FoRTE-Research/EnergyReplay/energyReplay/energyReplay.pdf

energyReplay

# Reference | Qty Value

1 C1, C2, C3, C4 | 4 100n
2 C5 | 1 10u
3 C6 | 1 2.2n
4 C7 | 1 0.1u
5 C8 | 1 4.7u
6 C9, C10 | 2 11u
7 H1, H2, H3, H4 | 4 MountingHole
8 J1 | 1 Conn_02x07_Odd_Even
9 J2 | 1 Power Select
10 J3, J4, J6, J7 | 4 Conn_01x02_Pin
11 J5 | 1 Conn_02x10_Counter_Clockwise
12 L1 | 1 2.2u
13 LED1 | 1 LTST-C155GEKT
14 LED2 | 1 19-237/R6GHBHC-A04/2T
15 R1 | 1 47k
16 R2 | 1 150
17 R3 | 1 120
18 R4 | 1 110
19 R5 | 1 20
20 R6 | 1 43
21 R7, R8 | 2 4.7k
22 R9 | 1 10k
23 R10 | 1 12k
24 R11 | 1 120k
25 R12 | 1 68k
26 R13 | 1 500m
27 R14, R15 | 2 1k
28 R16, R17 | 2 150k
29 SW1, SW2 | 2 SW_Push
30 U1 | 1 MSP430FR5994IPN
31 U2 | 1 MCP4725xxx-xCH
32 U3 | 1 OPA2387DGKR
33 U4 | 1 TPS613222ADBV
34 U5 | 1 LM66100DCKR

energyReplay

Footprint | DNP
Capacitor_SMD:C_1206_3216Metric Capacitor_SMD:C_1206_3216Metric Capacitor_SMD:C_1206_3216Metric Capacitor_SMD:C_1206_3216Metric Capacitor_SMD:C_1206_3216Metric Capacitor_SMD:C_1206_3216Metric MountingHole:MountingHole_3.2mm_M3 Connector_PinHeader_2.54mm:PinHeader_2x07_P2.54mm_Vertical Connector_PinHeader_2.54mm:PinHeader_1x03_P2.54mm_Vertical Connector_PinHeader_2.54mm:PinHeader_1x02_P2.54mm_Vertical Connector_PinHeader_2.54mm:PinHeader_2x10_P2.54mm_Vertical Inductor_SMD:L_1206_3216Metric LTST-C155GEKT:DIODE_LTST-C155GEKT_LTO EAST1616RGBA3:EAST1616RGB_SMD_B_EVE Resistor_SMD:R_1206_3216Metric Resistor_SMD:R_1206_3216Metric Resistor_SMD:R_1206_3216Metric Resistor_SMD:R_1206_3216Metric Resistor_SMD:R_1206_3216Metric Resistor_SMD:R_1206_3216Metric Resistor_SMD:R_1206_3216Metric Resistor_SMD:R_1206_3216Metric Resistor_SMD:R_1206_3216Metric Resistor_SMD:R_1206_3216Metric Resistor_SMD:R_1206_3216Metric Resistor_SMD:R_1206_3216Metric Resistor_SMD:R_1206_3216Metric Resistor_SMD:R_1206_3216Metric TL59NF160Q:SW_TL59NF160Q
MSP430FR5994IPN:PN0080A_N
Package_TO_SOT_SMD:SOT-23-6 OPA2387DGK:DGK0008A-IPC_A
Package_TO_SOT_SMD:SOT-23-5 LM66100DCKR:DCK6_TEX
