FoRTE-Research/EnergyReplay/energyReplay/energyReplay.csv

Id | Designator | Footprint | Quantity | Designation | Supplier and ref
1 | R13 | R_1206_3216Metric | 1 | 500m
2 | R12 | R_1206_3216Metric | 1 | 68k
3 | SW2,SW1 | SW_TL59NF160Q | 2 | SW_Push
4 | LED1 | DIODE_LTST-C155GEKT_LTO | 1 | LTST-C155GEKT
5 | J7,J3,J6,J4 | PinHeader_1x02_P2.54mm_Vertical | 4 | Conn_01x02_Pin
6 | C12,C3,C4,C1,C2,C11 | C_1206_3216Metric | 6 | 100n
7 | H1,H2,H4,H3 | MountingHole_3.2mm_M3 | 4 | MountingHole
8 | C9,C10 | C_1206_3216Metric | 2 | 22u
9 | R10 | R_1206_3216Metric | 1 | 12k
10 | C8 | C_1206_3216Metric | 1 | 4.7u
11 | U4 | SOT-23-5 | 1 | TPS613222ADBV
12 | C6 | C_1206_3216Metric | 1 | 2.2n
13 | J5 | PinHeader_2x10_P2.54mm_Vertical | 1 | Conn_02x10_Counter_Clockwise
14 | R1 | R_1206_3216Metric | 1 | 47k
15 | LED2 | EAST1616RGB_SMD_B_EVE | 1 | 19-237/R6GHBHC-A04/2T
16 | R7,R8 | R_1206_3216Metric | 2 | 4.7k
17 | R11 | R_1206_3216Metric | 1 | 120k
18 | R4 | R_1206_3216Metric | 1 | 110
19 | U3 | DGK0008A-IPC_A | 1 | OPA2387DGKR
20 | R9 | R_1206_3216Metric | 1 | 10k
21 | R6 | R_1206_3216Metric | 1 | 43
22 | U5 | DCK6_TEX | 1 | LM66100DCKR
23 | R14,R15 | R_1206_3216Metric | 2 | 1k
24 | U2 | SOT-23-6 | 1 | MCP4725xxx-xCH
25 | U1 | PN0080A_N | 1 | MSP430FR5994IPN
26 | C5 | C_1206_3216Metric | 1 | 10u
27 | J1 | PinHeader_2x07_P2.54mm_Vertical | 1 | Conn_02x07_Odd_Even
28 | J2 | PinHeader_1x03_P2.54mm_Vertical | 1 | Power Select
29 | R3 | R_1206_3216Metric | 1 | 120
30 | C7 | C_1206_3216Metric | 1 | 0.1u
31 | Y1 | XTAL_MS1V-T1K-32.768KHZ-12.5PF-20PPM-TA-QC | 1 | Crystal
32 | L1 | L_1210_3225Metric | 1 | 2.2u
33 | R16,R17 | R_1206_3216Metric | 2 | 150k
34 | R2 | R_1206_3216Metric | 1 | 150
35 | R5 | R_1206_3216Metric | 1 | 20
