FoRTE-Research/EnergyReplay/pdf/pcb.pdf

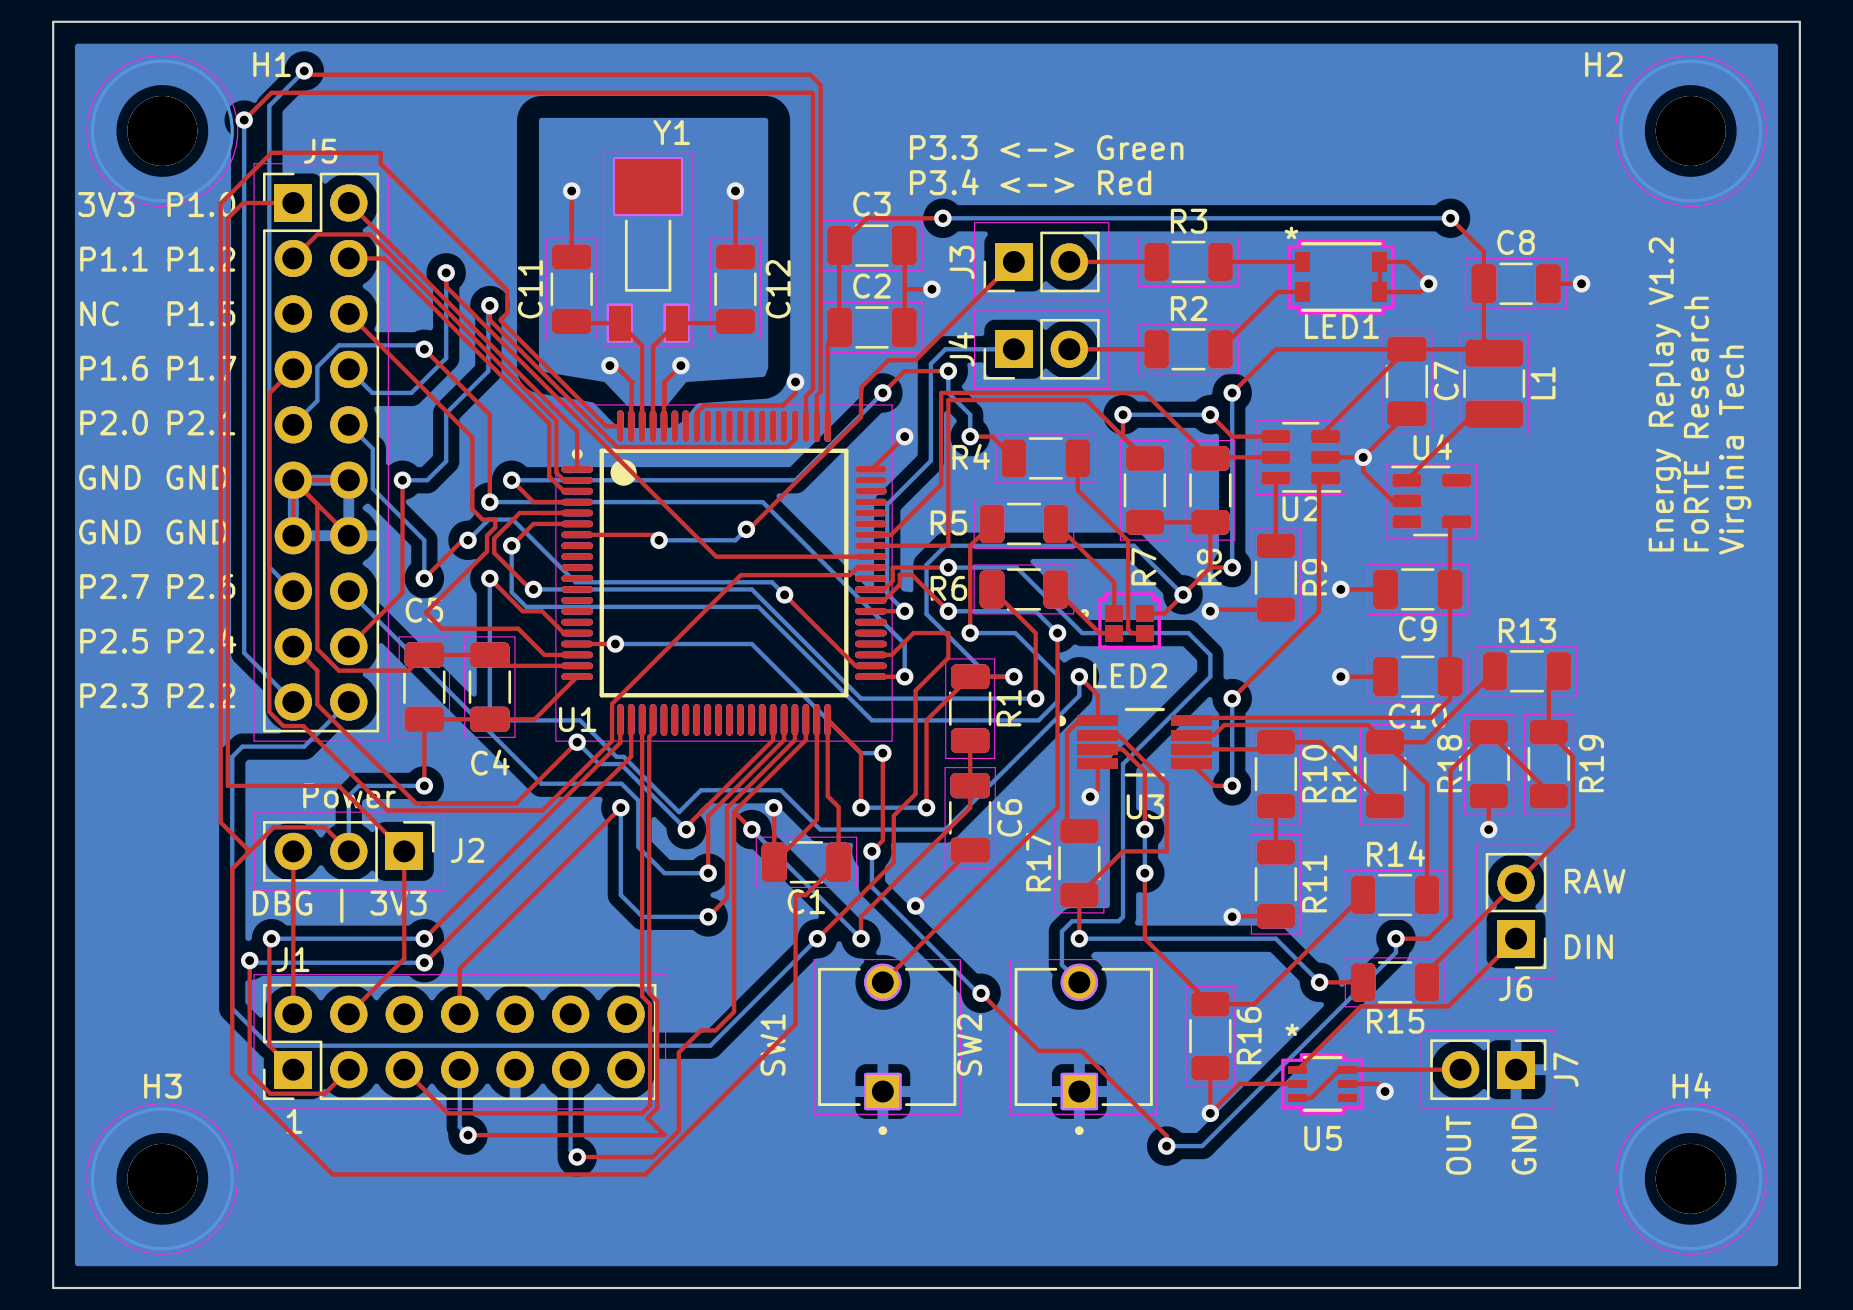
[picture p1: page 1]
