FoRTE-Research/EnergyReplay/spice/diffAmp.asc

I1: current; SINE(20m 20m 1)
R1: res; 1Meg
R2: res; 500m
R3: res; 1k
R4: res; 1k
R5: res; 150k
R6: res; 150k
R7: res; 1k
U1: UniversalOpAmp
V1: voltage; 5
Named nets: 0, Vdd, Vout, Vhi, Vlo
.tran 20
