FoRTE-Research/EnergyReplay/spice/gainAmp.asc

R1: res; 100Meg
R2: res; 68k
R3: res; 120k
R4: res; 12k
U1: UniversalOpAmp
V1: voltage; 5
V2: voltage; SINE(0 3.3 1)
Named nets: 0, Vdd
