FoRTE-Research/EnergyReplay/energyReplay/energyReplay.kicad_pcb

## KiCad design energyReplay/energyReplay.kicad_pcb (2025-04-21)

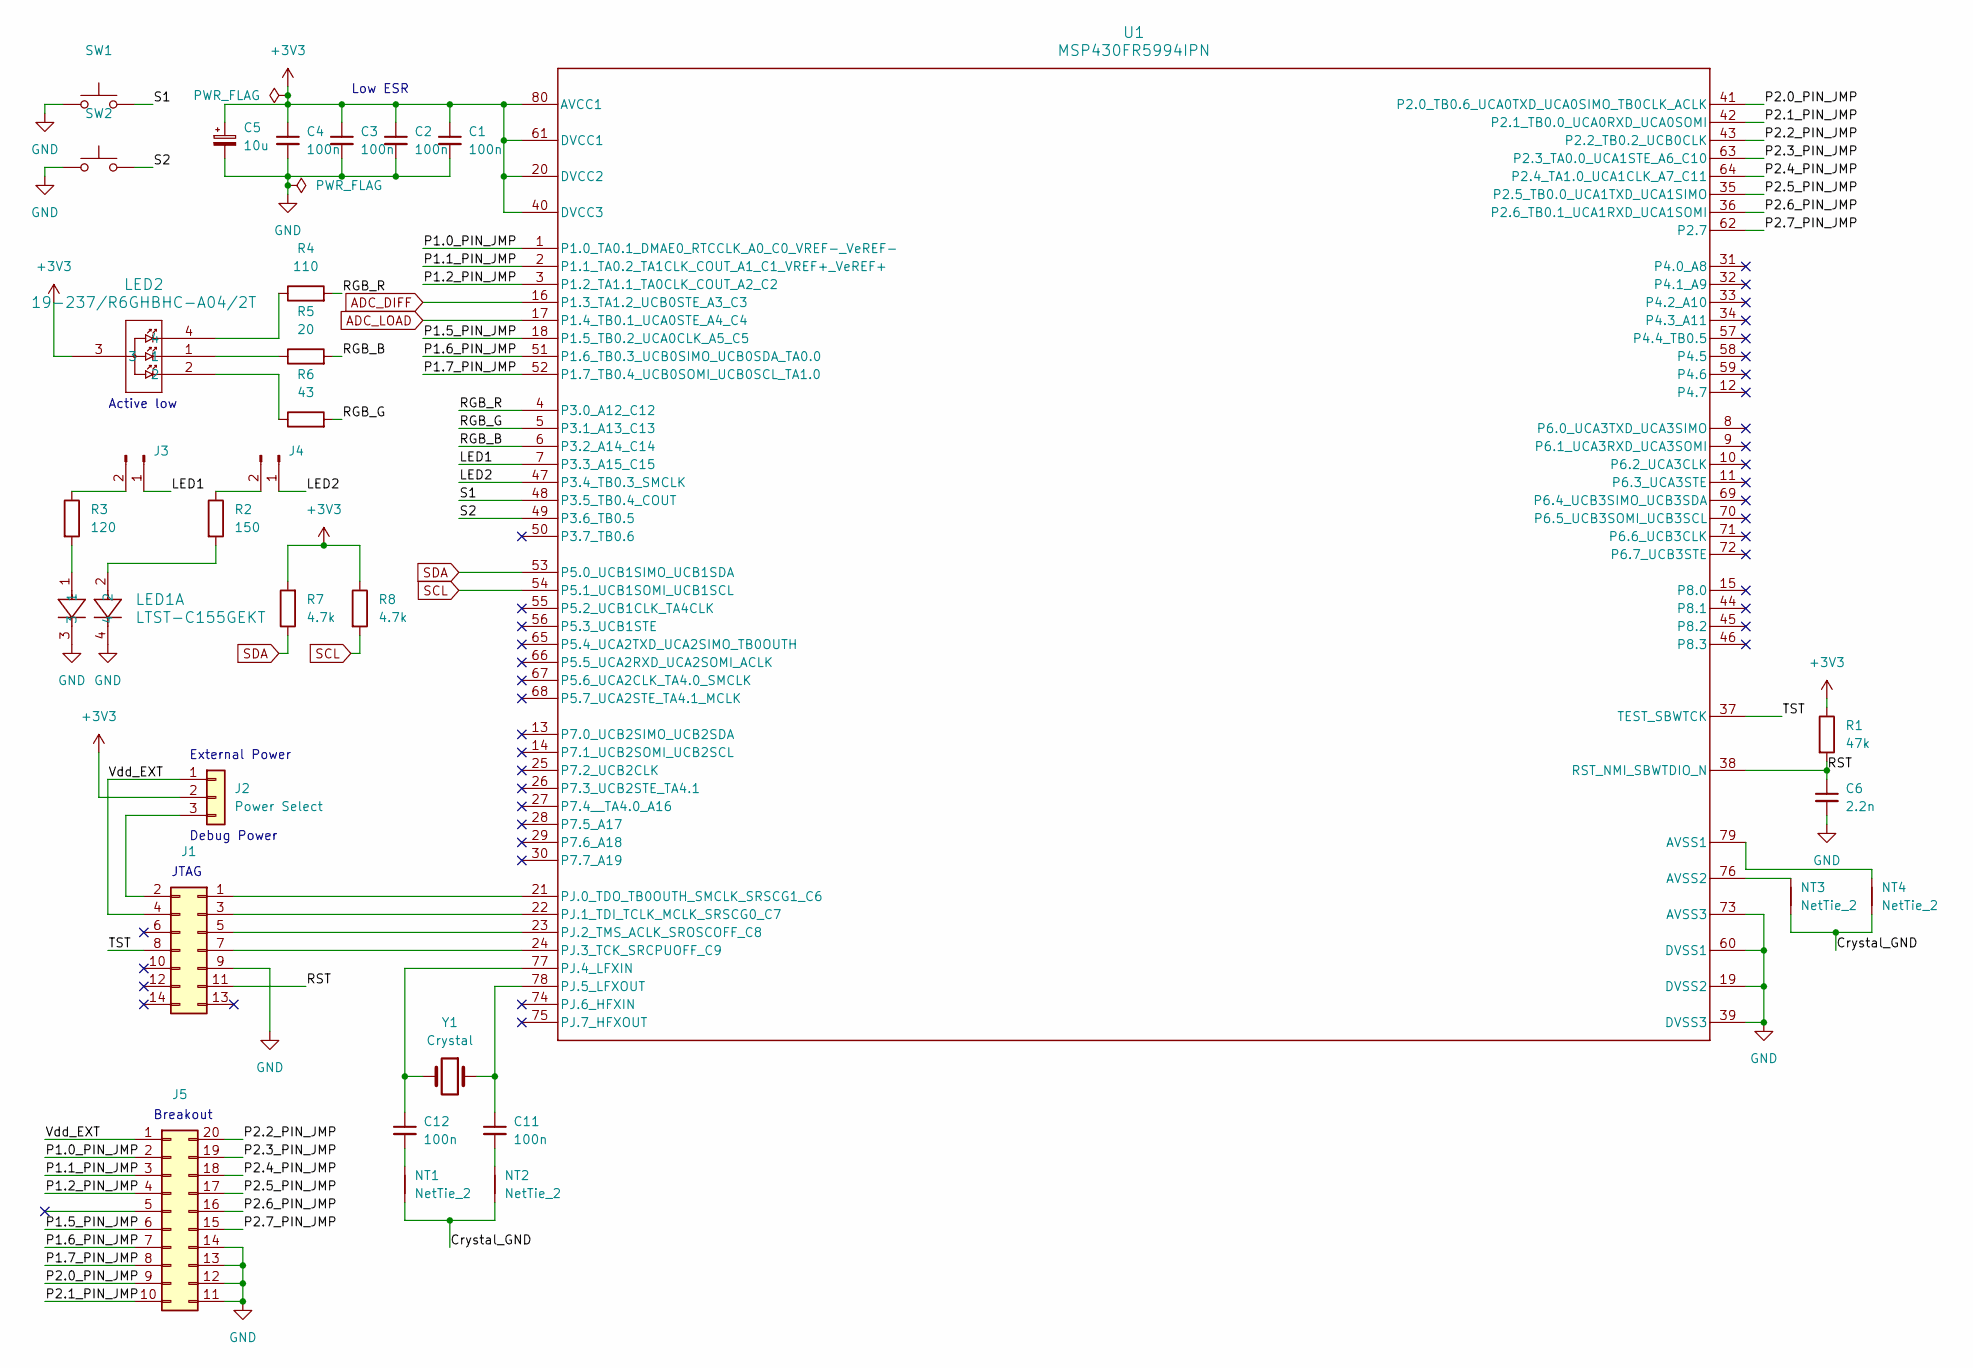
[picture p5: schematic Control.kicad_sch, Control MCU]

Parts:
C1, C2, C3, C4, C11, C12: 100n; C_1206_3216Metric
C5: 10u; C_1206_3216Metric
C6: 2.2n; C_1206_3216Metric
J1: Conn_02x07_Odd_Even; PinHeader_2x07_P2.54mm_Vertical
J2: Power Select; PinHeader_1x03_P2.54mm_Vertical
J3, J4: Conn_01x02_Pin; PinHeader_1x02_P2.54mm_Vertical
J5: Conn_02x10_Counter_Clockwise; PinHeader_2x10_P2.54mm_Vertical
LED1: LTST-C155GEKT; DIODE_LTST-C155GEKT_LTO
LED2: 19-237/R6GHBHC-A04/2T; EAST1616RGB_SMD_B_EVE
NT1, NT2, NT3, NT4: NetTie_2; NetTie-2_SMD_Pad0.2mm
R1: 47k; R_1206_3216Metric
R2: 150; R_1206_3216Metric
R3: 120; R_1206_3216Metric
R4: 110; R_1206_3216Metric
R5: 20; R_1206_3216Metric
R6: 43; R_1206_3216Metric
R7, R8: 4.7k; R_1206_3216Metric
SW1, SW2: SW_Push; SW_TL59NF160Q
U1: MSP430FR5994IPN; PN0080A_N
Y1: Crystal; XTAL_MS1V-T1K-32.768KHZ-12.5PF-20PPM-TA-QC

Connections:
+3V3: C1.1, C2.1, C3.1, C4.1, C5.1, J2.2, LED2.3, R1.1, R7.2, R8.1, U1.20 (DVCC2), U1.40 (DVCC3), U1.61 (DVCC1), U1.80 (AVCC1); also elsewhere on the board
/Control/Crystal_GND: NT1.1, NT2.1, NT3.1, NT4.1
/Control/LED1: J3.1, U1.7 (P3.3_A15_C15)
/Control/LED2: J4.1, U1.47 (P3.4_TB0.3_SMCLK)
/Control/P1.0_PIN_JMP: J5.2, U1.1 (P1.0_TA0.1_DMAE0_RTCCLK_A0_C0_VREF-_VeR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)
/Control/P1.1_PIN_JMP: J5.3, U1.2 (P1.1_TA0.2_TA1CLK_COUT_A1_C1_VREF+_VeRE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)
/Control/P1.2_PIN_JMP: J5.4, U1.3 (P1.2_TA1.1_TA0CLK_COUT_A2_C2)
/Control/P1.5_PIN_JMP: J5.6, U1.18 (P1.5_TB0.2_UCA0CLK_A5_C5)
/Control/P1.6_PIN_JMP: J5.7, U1.51 (P1.6_TB0.3_UCB0SIMO_UCB0SDA_TA0.0)
/Control/P1.7_PIN_JMP: J5.8, U1.52 (P1.7_TB0.4_UCB0SOMI_UCB0SCL_TA1.0)
/Control/P2.0_PIN_JMP: J5.9, U1.41 (P2.0_TB0.6_UCA0TXD_UCA0SIMO_TB0CLK_ACLK)
/Control/P2.1_PIN_JMP: J5.10, U1.42 (P2.1_TB0.0_UCA0RXD_UCA0SOMI)
/Control/P2.2_PIN_JMP: J5.20, U1.43 (P2.2_TB0.2_UCB0CLK)
/Control/P2.3_PIN_JMP: J5.19, U1.63 (P2.3_TA0.0_UCA1STE_A6_C10)
/Control/P2.4_PIN_JMP: J5.18, U1.64 (P2.4_TA1.0_UCA1CLK_A7_C11)
/Control/P2.5_PIN_JMP: J5.17, U1.35 (P2.5_TB0.0_UCA1TXD_UCA1SIMO)
/Control/P2.6_PIN_JMP: J5.16, U1.36 (P2.6_TB0.1_UCA1RXD_UCA1SOMI)
/Control/P2.7_PIN_JMP: J5.15, U1.62 (P2.7)
/Control/RGB_B: R5.2, U1.6 (P3.2_A14_C14)
/Control/RGB_G: R6.2, U1.5 (P3.1_A13_C13)
/Control/RGB_R: R4.2, U1.4 (P3.0_A12_C12)
/Control/RST: C6.1, J1.11, R1.2, U1.38 (RST_NMI_SBWTDIO_N)
/Control/S1: SW1.2, U1.48 (P3.5_TB0.4_COUT)
/Control/S2: SW2.2, U1.49 (P3.6_TB0.5)
/Control/TST: J1.8, U1.37 (TEST_SBWTCK)
/Control/Vdd_EXT: J1.4, J2.1, J5.1
ADC_DIFF: U1.16 (P1.3_TA1.2_UCB0STE_A3_C3); also elsewhere on the board
ADC_LOAD: U1.17 (P1.4_TB0.1_UCA0STE_A4_C4); also elsewhere on the board
GND: C1.2, C2.2, C3.2, C4.2, C5.2, C6.2, J1.9, J5.11, J5.12, J5.13, J5.14, LED1.3, LED1.4, SW1.1, SW2.1, U1.19 (DVSS2), U1.39 (DVSS3), U1.60 (DVSS1), U1.73 (AVSS3); also elsewhere on the board
unnamed: C11.2, NT2.2
unnamed: C12.2, NT1.2
unnamed: J1.1, U1.21 (PJ.0_TDO_TB0OUTH_SMCLK_SRSCG1_C6)
unnamed: J1.2, J2.3
unnamed: J1.3, U1.22 (PJ.1_TDI_TCLK_MCLK_SRSCG0_C7)
unnamed: J1.5, U1.23 (PJ.2_TMS_ACLK_SROSCOFF_C8)
unnamed: J1.7, U1.24 (PJ.3_TCK_SRCPUOFF_C9)
unnamed: J3.2, R3.1
unnamed: J4.2, R2.1
unnamed: LED1.1, R3.2
unnamed: LED1.2, R2.2
unnamed: LED2.1, R5.1
unnamed: LED2.2, R6.1
unnamed: LED2.4, R4.1
unnamed: NT4.2, U1.79 (AVSS1)
unnamed: NT3.2, U1.76 (AVSS2)
unnamed: C12.1, U1.77 (PJ.4_LFXIN), Y1.2
unnamed: C11.1, U1.78 (PJ.5_LFXOUT), Y1.1
SCL: R8.2, U1.54 (P5.1_UCB1SOMI_UCB1SCL); also elsewhere on the board
SDA: R7.1, U1.53 (P5.0_UCB1SIMO_UCB1SDA); also elsewhere on the board

Notes on the sheet:
JTAG
Debug Power
Active low
Breakout
Low ESR
External Power

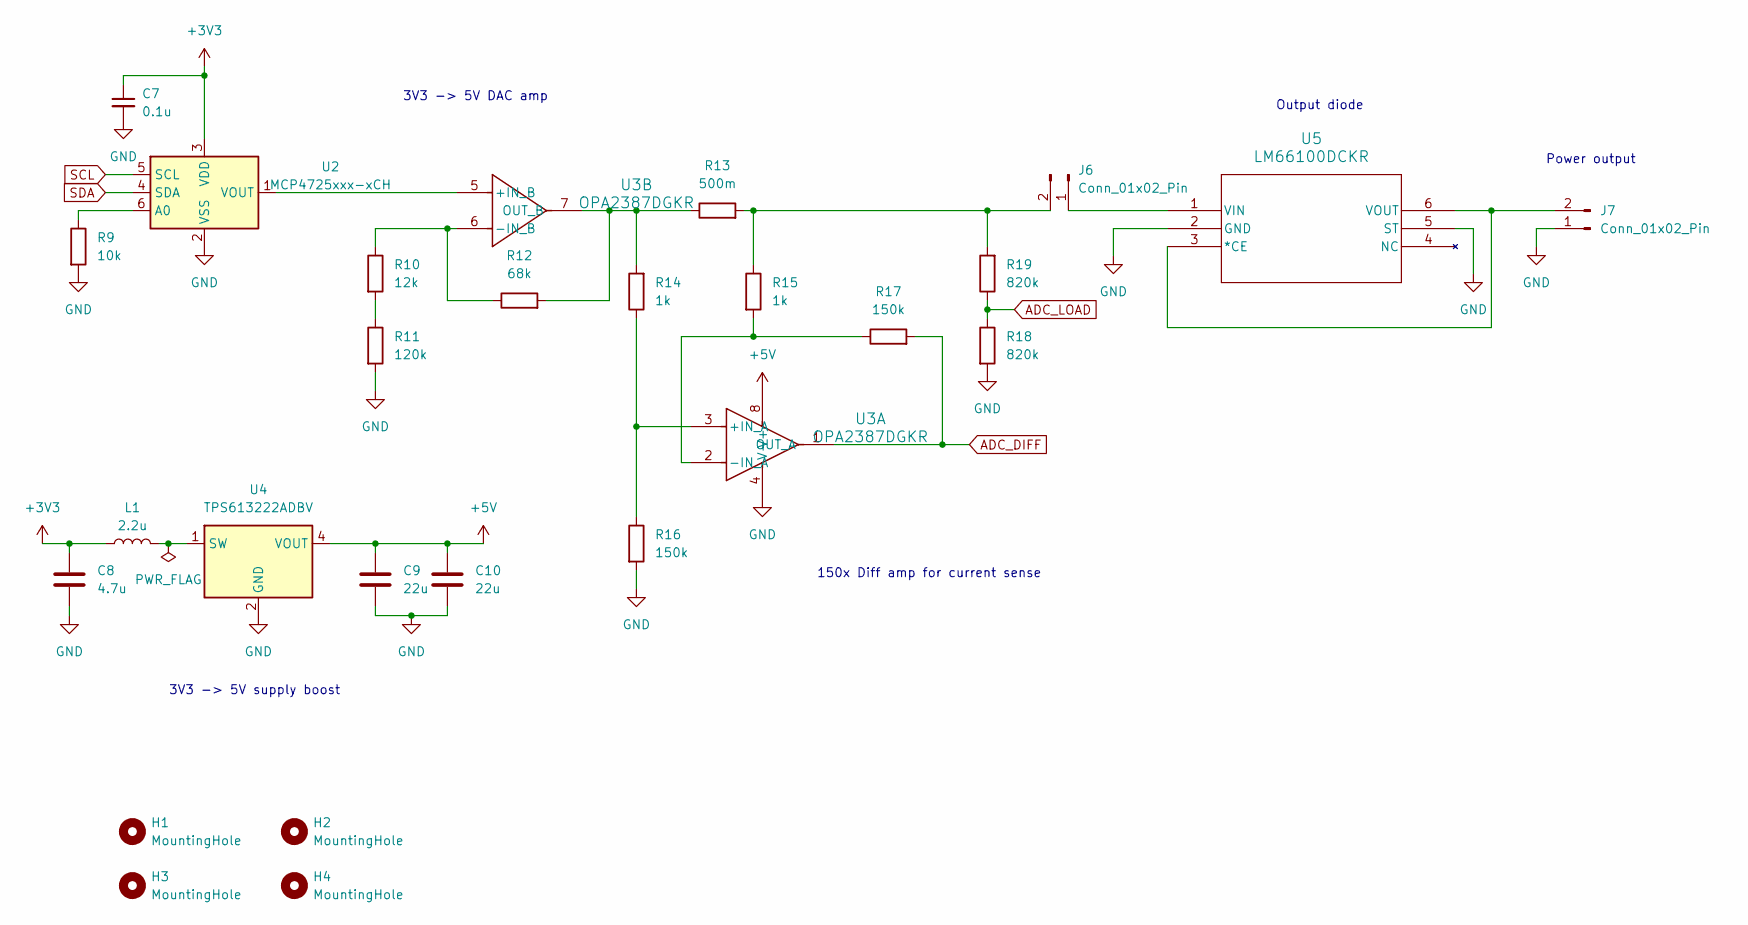
[picture p6: schematic output.kicad_sch, Power/Measurement]

Parts:
C7: 0.1u; C_1206_3216Metric
C8: 4.7u; C_1206_3216Metric
C9, C10: 22u; C_1206_3216Metric
H1, H2, H3, H4: MountingHole; MountingHole_3.2mm_M3
J6, J7: Conn_01x02_Pin; PinHeader_1x02_P2.54mm_Vertical
L1: 2.2u; L_1210_3225Metric
R9: 10k; R_1206_3216Metric
R10: 12k; R_1206_3216Metric
R11: 120k; R_1206_3216Metric
R12: 68k; R_1206_3216Metric
R13: 500m; R_1206_3216Metric
R14, R15: 1k; R_1206_3216Metric
R16, R17: 150k; R_1206_3216Metric
R18, R19: 820k; R_1206_3216Metric
U2: MCP4725xxx-xCH; SOT-23-6
U3: OPA2387DGKR; DGK0008A-IPC_A
U4: TPS613222ADBV; SOT-23-5
U5: LM66100DCKR; DCK6_TEX

Connections:
+3V3: C7.1, C8.1, L1.1, U2.3 (VDD); also elsewhere on the board
+5V: C9.1, C10.1, U3.8 (V+), U4.4 (VOUT)
ADC_DIFF: R17.2, U3.1 (OUT_A); also elsewhere on the board
ADC_LOAD: R18.1, R19.1; also elsewhere on the board
GND: C7.2, C8.2, C9.2, C10.2, J7.1, R9.2, R11.2, R16.2, R18.2, U2.2 (VSS), U3.4 (V-), U4.2 (GND), U5.2 (GND), U5.5 (ST); also elsewhere on the board
unnamed: J6.1, U5.1 (VIN)
unnamed: J6.2, R13.2, R15.1, R19.2
unnamed: J7.2, U5.3 (*CE), U5.6 (VOUT)
unnamed: R10.2, R11.1
unnamed: R9.1, U2.6 (A0)
unnamed: U2.1 (VOUT), U3.5 (+IN_B)
unnamed: R14.1, R16.1, U3.3 (+IN_A)
unnamed: R15.2, R17.1, U3.2 (-IN_A)
unnamed: R10.1, R12.1, U3.6 (-IN_B)
unnamed: R12.2, R13.1, R14.2, U3.7 (OUT_B)
unnamed: L1.2, U4.1 (SW)
SCL: U2.5 (SCL); also elsewhere on the board
SDA: U2.4 (SDA); also elsewhere on the board

Notes on the sheet:
Output diode
3V3 -> 5V DAC amp
Power output
3V3 -> 5V supply boost
150x Diff amp for current sense

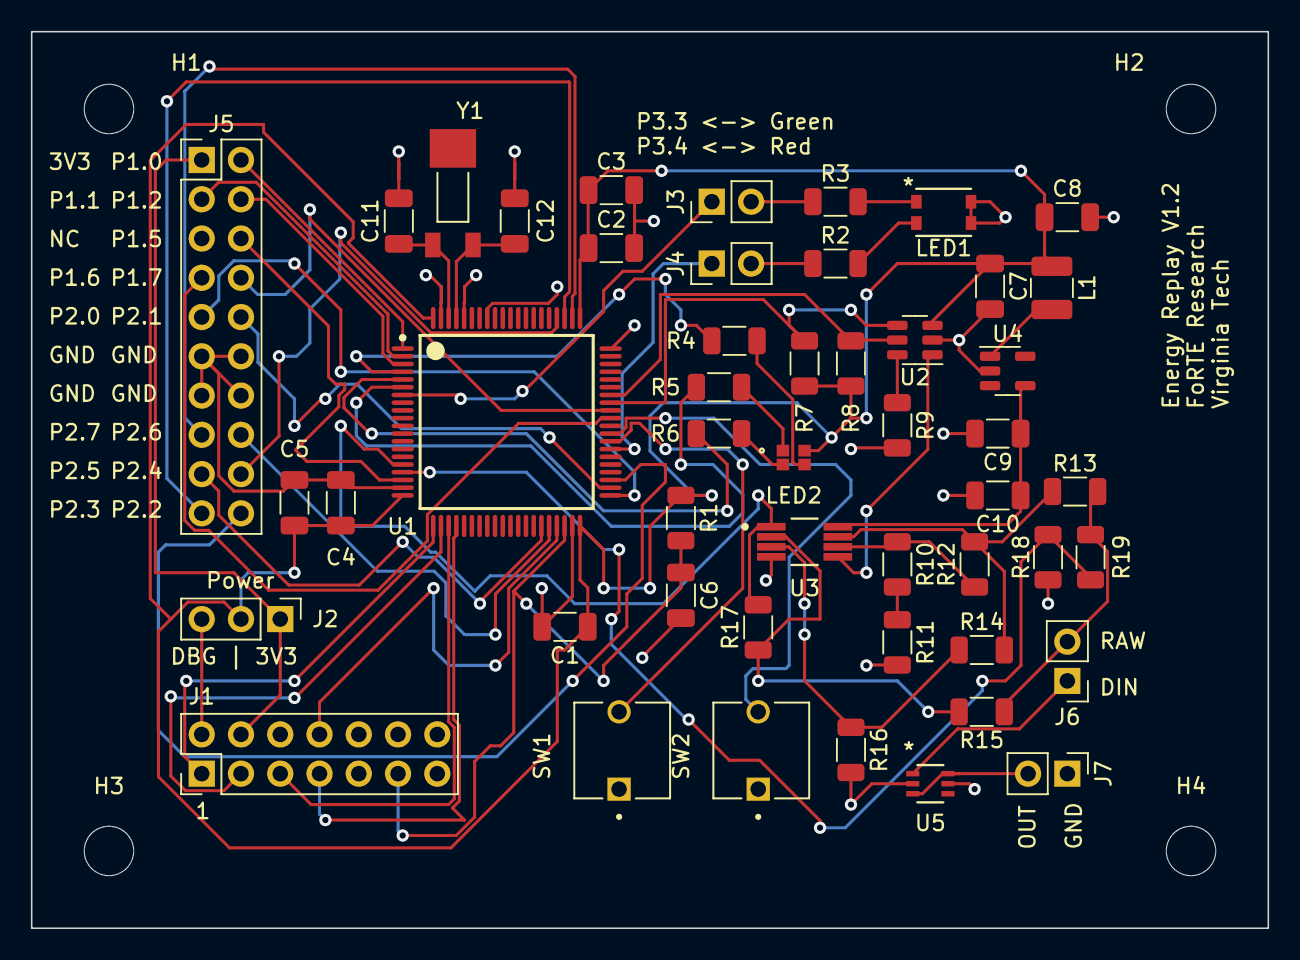
[picture p7: board energyReplay.kicad_pcb from above]

Board: 2 copper layers, 80.0 x 58.0 mm, 57 parts (0 on the bottom side), 61 nets.
