FoRTE-Research/EnergyReplay/(commit log)

2024-09-25 1.1 KiCAD project
2025-04-21 1.2 KiCAD project and code
2025-05-01 Upload v1.2 pcb and sch pdf
